Heideachim/WordClock/doc/Dokumentation.odt

Genau mein MAS-Modul: https://wolles-elektronikkiste.de/dcf77-funkuhr

Vertrieb meines Moduls: https://techfun.sk/wp-content/uploads/2020/08/3942_2.pdf

Masse = Pin G
Betriebsspannung = Pin V
Daten = Pin T
Power on/off = Pin P1 (Ein-/Ausschalter, muss auf logisch LOW gesetzt sein )
Die restlichen Pins können ausgelassen werden.

1.00 Es ist ein Uhr

1.05 Es ist fünf nach eins

1.10 Es ist zehn nach eins

1.15 Es ist viertel nach eins

Es ist viertel zwei

1.20 Es ist zwanzig nach eins

1.25 Es ist fünf vor halb zwei

Es ist fünfundzwanzig nach eins

1.30 Es ist halb zwei

1.35 Es ist fünf nach halb zwei

1.40 Es ist fünf vor dreiviertel

Es ist zwanzig vor zwei

1.45 Es ist viertel vor zwei

1.50 Es ist zehn vor zwei

1.55 Es ist fünf vor zwei

Es ist | genau | fünf | nach | halb | eins | Uhr
| | zehn | vor | (dreiviertel) | ein
| | viertel | | | zwei
| | zwanzig | | | drei
| | | | | vier
| | | | | fünf
| | | | | sechs
| | | | | sieben
| | | | | acht
| | | | | neun
| | | | | zehn
| | | | | elf
| | | | | zwölf

21 bis 24 Wörter

6 x 4 = 24 → 1 übrig

7 x 3 = 21 → trifft genau

5 x 5 = 25 → viele übrig

Minimale Breite des Gehäuses: 6cm wegen Ferrit-Antenne

Ikea-Bilderrahmen Ribba: 21 x 30cm; innere Öffnung: 19,9 x 28,9cm

| | fünf | nach | halb | eins
| | zehn | vor | | ein
| | viertel | | | zwei
| | zwanzig | | | drei
| | | | | etc.
1.00 | Es ist ein Uhr | | | | ein
1.05 | Es ist fünf nach eins | fünf | nach | | eins
1.10 | Es ist zehn nach eins | zehn | nach | | eins
1.15 | Es ist viertel nach eins | viertel | nach | | eins
1.20 | Es ist zwanzig nach eins | zwanzig | nach | | eins
1.25 | Es ist fünf vor halb zwei | fünf | vor | halb | zwei
1.30 | Es ist halb zwei | | | halb | zwei
1.35 | Es ist fünf nach halb zwei | fünf | nach | halb | zwei
1.40 | Es ist zwanzig vor zwei | zwanzig | vor | | zwei
1.45 | Es ist viertel vor zwei | viertel | vor | | zwei
1.50 | Es ist zehn vor zwei Uhr | zehn | vor | | zwei
1.55 | Es ist fünf vor zwei Uhr | fünf | vor | | zwei
