Heideachim/WordClock/(commit log)

2021-12-08 Text-Dokumentation dazu: Grundlagen und Muster für ein 'Ziffernblatt'
    [Ziffernblatt.ods]
2021-12-08 VS Code Beispiel, das grob die Zeit dekodiert. Ausgabe als Text, nicht auf den LEDs
2021-12-08 Hardware-Test für DCF77-Empfänger und einen WS2812 Streifen
2021-12-08 Auf Minuten erweitert; kleinere Unstimmigkeiten behoben
    [main.cpp]
2021-12-09 Einzeilige Konfiguration hinzugefügt, für die Entwicklung oder eine ganz schmale aber lange Uhr.
    [Ziffernblatt.ods]
2021-12-20 DCF77 und Fastled entkoppelt, jetzt funktioniert es manchmal
2021-12-25 Interrupt bei FALLENDER Flanke, für CDF77-Empfänger mit invertierter Polarität
2021-12-25 Erste Version der richtigen Wort-Uhr; Programm oder Hardware stürzen ab
    [Ziffernblatt.ods]
2022-01-24 Letzte Zahl (sieben) wurde nie angezeigt, wegen zu enger Bereichsprüfung; Debug-LED invertiert
